machmar/pixelpine/docs/eu-compliance/declaration-of-conformity.md

# EU Declaration of Conformity — template

*Fill in the `<…>` fields, print on company letterhead, sign after the EMC report and RoHS evidence are in the
technical file. Keep the signed original with the technical file. A copy (or a web link to it) accompanies the
product when an authority asks. For RoHS/EMC it need not be in the box.*

---

**EU DECLARATION OF CONFORMITY** · No. `<PP-DoC-001>`

1. **Product:** PixelPine, decorative LED Christmas tree\
   Model / type: **PP-240-WW** · Hardware revision: **A** · Firmware: `<x.y>`\
   Batch / serial range: `<from YYWW-L>`

2. **Name and address of the manufacturer:**\
   **MachStuff s.r.o.**, Jehličková 240, 240 24 Stromečkov, Czech Republic, IČO `<company ID>`, marekmach24@gmail.com

3. This declaration of conformity is issued under the sole responsibility of the manufacturer.

4. **Object of the declaration:** a USB-C powered (5 V DC, 0.1 W max) decorative PCB luminaire in the shape of a
   Christmas tree with 240 warm-white LEDs and a capacitive touch control, as shown in the photo `<attach photo>`.

5. The object of the declaration described above is in conformity with the relevant Union harmonisation
   legislation:
   - **Directive 2014/30/EU** (electromagnetic compatibility)
   - **Directive 2011/65/EU** (RoHS) as amended by Commission Delegated Directive **(EU) 2015/863**

6. **References to the relevant harmonised standards used:**
   - EN IEC 55015:2019 + A11:2020: limits and methods of measurement of radio disturbance characteristics of
     electrical lighting and similar equipment
   - EN 61547:2009: equipment for general lighting purposes, EMC immunity requirements
   - EN IEC 63000:2018: technical documentation for the assessment of electrical and electronic products with
     respect to the restriction of hazardous substances

7. **Conformity assessment procedure:** internal production control (Module A, Annex II of Directive 2014/30/EU).
   No notified body involved.
   EMC test report: `<lab name>`, report no. `<…>`, dated `<…>`.

8. **Additional information:** the product is not a toy (Directive 2009/48/EC, Annex I). It is outside the scope of
   Regulations (EU) 2019/2020 and 2019/2015 (luminous flux ≈ 2 lm < 60 lm).

Signed for and on behalf of: **MachStuff s.r.o.**

Place and date of issue: Stromečkov, `<DD. MM. 2026>`

Name, function: `<Name Surname, jednatel / managing director>`

Signature: ______________________
