machmar/pixelpine/hardware/production/preview_stand_bottom.png

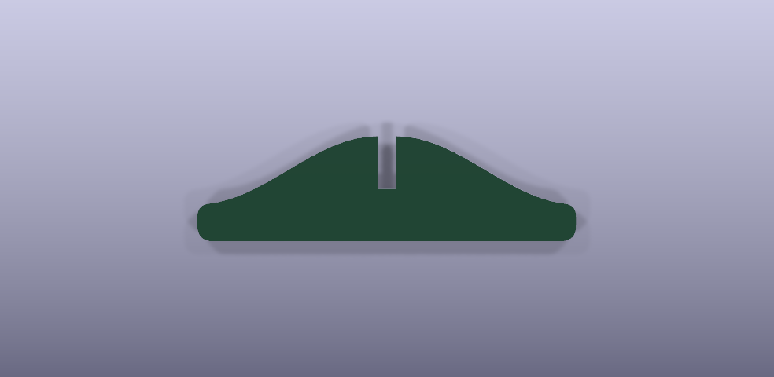
hardware/production/preview_stand_bottom.png
