machmar/pixelpine/hardware/production/preview_tree_bottom.png

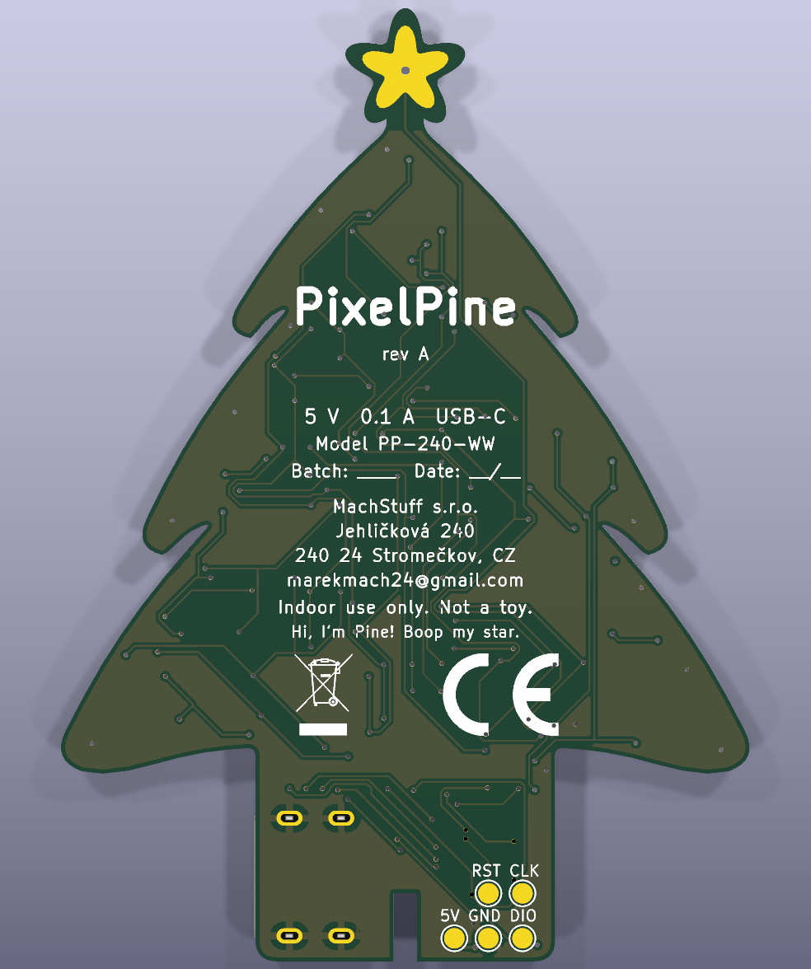
hardware/production/preview_tree_bottom.png
