machmar/pixelpine/hardware/production/preview_tree_top.png

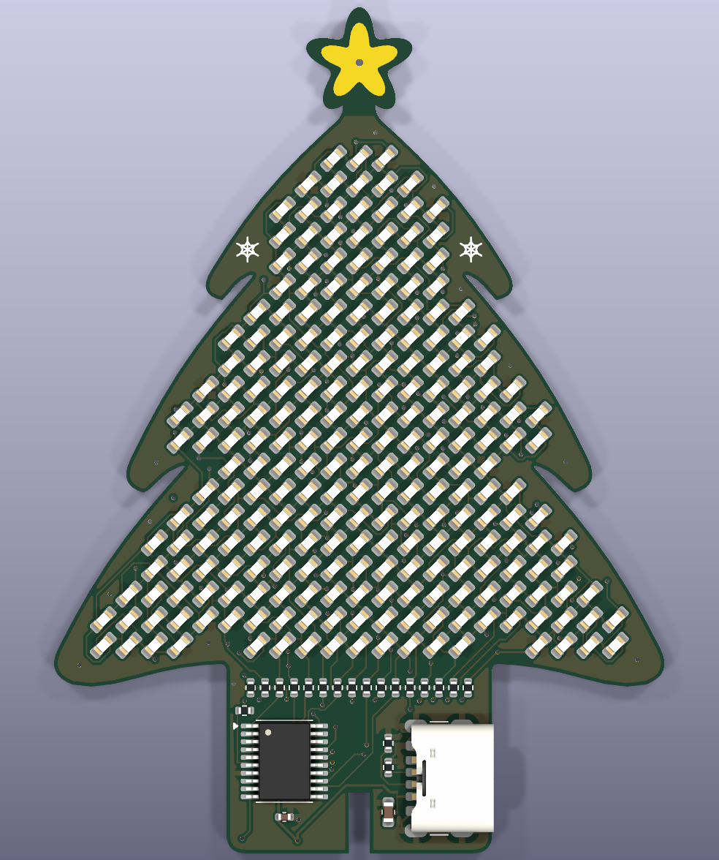
hardware/production/preview_tree_top.png
