machmar/pixelpine/hardware/renders/led_islands.png

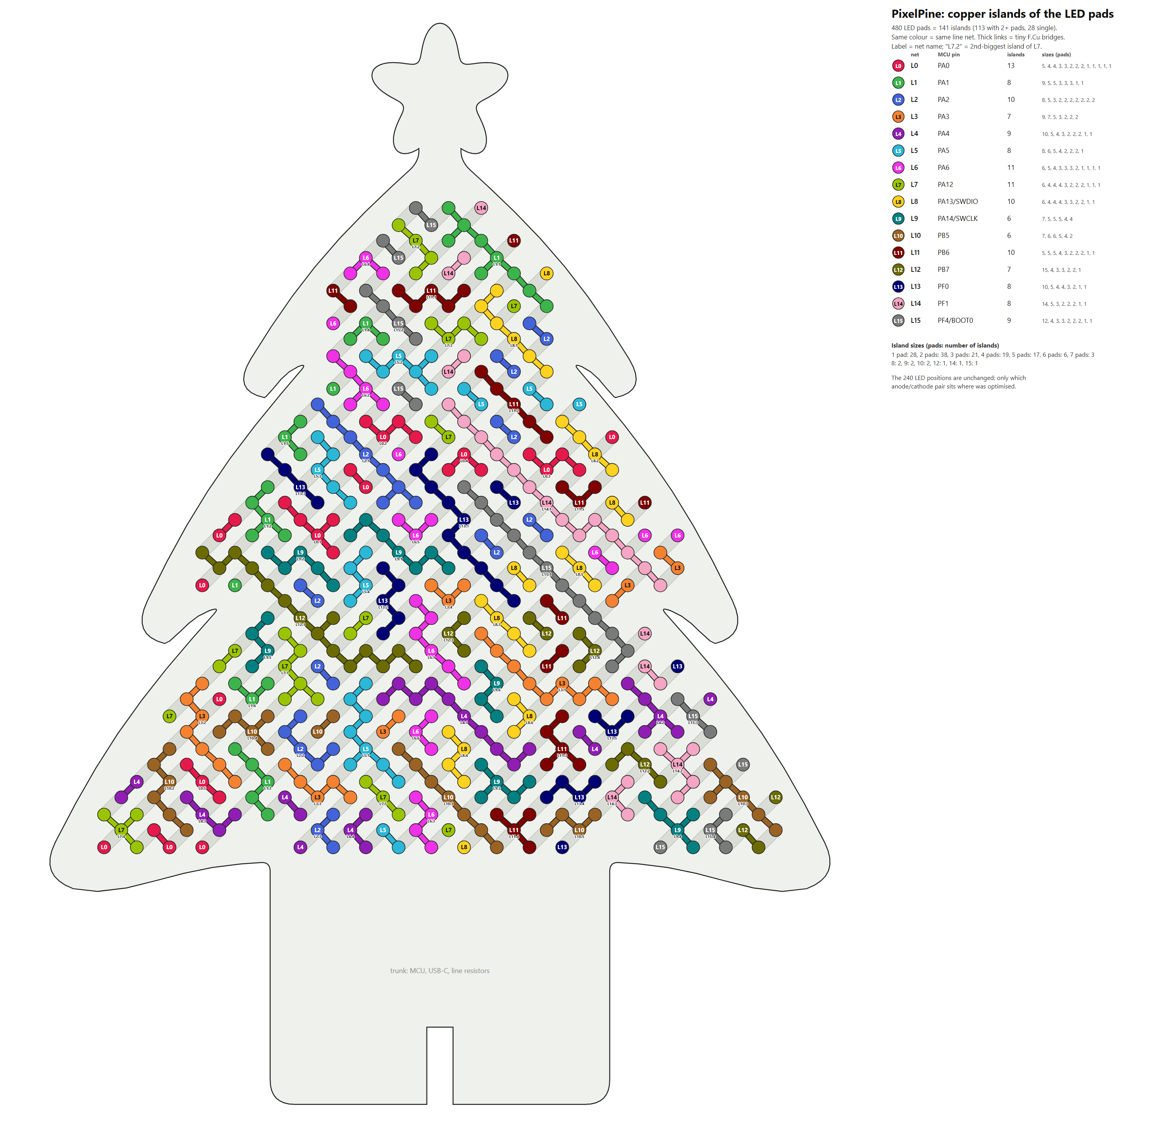
hardware/renders/led_islands.png
