machmar/pixelpine/docs/eu-compliance/labelling-and-instructions.md

# Labelling, packaging and user information — PixelPine rev A

## On the product (back silkscreen, already in the KiCad layout)

| Marking | Required by | Status |
|---|---|---|
| **CE** logo (≥ 5 mm high) | EMC / RoHS | ✅ 8.5 × 6 mm, KiCad `Symbol:CE-Logo_8.5x6mm_SilkScreen` |
| Crossed-out wheeled bin + bar | WEEE Art. 14, EN 50419 | ✅ 4.2 × 6 mm |
| Model **PP-240-WW**, rev A | EMC Art. 7(5), GPSR Art. 9(5) | ✅ |
| Batch / date field `Batch: ____ Date: __/__` | GPSR traceability | ✅ filled by paint marker or replaced by a laser mark |
| Manufacturer name, postal address, e-mail | EMC Art. 7(6), GPSR Art. 9(6) | ✅ MachStuff s.r.o., Jehličková 240, 240 24 Stromečkov, marekmach24@gmail.com (the address is made up for the school project: use the registered one for a real product) |
| Rating `5 V 0.1 A USB-C` | good practice | ✅ |
| "Indoor use only. Not a toy." | GPSR risk measures | ✅ |

## Box (70 × 100 × 25 mm kraft, one-colour print)

**Front:** PixelPine · *240 little lights. One tiny tree.* · product photo glowing

**Back (EN / CZ):**

> **PixelPine** — LED Christmas tree · Vánoční stromeček s LED\
> Model PP-240-WW · 5 V ⎓ 0.1 A · USB-C (cable and charger not included · kabel a nabíječka nejsou součástí balení)
>
> ⚠ Not a toy. Not suitable for children under 3 years – small parts. Indoor use only.\
> ⚠ Nejedná se o hračku. Nevhodné pro děti do 3 let – malé části. Pouze pro vnitřní použití.
>
> CE · crossed-out bin · packaging sorting symbols (paper) · MachStuff s.r.o., Jehličková 240, 240 24 Stromečkov, marekmach24@gmail.com ·
> Made in China · Batch `YYWW-L`

## Leaflet (A7, folded into the box)

### EN

**Hello, I'm Pine.**

My job is to show you light shows. I'm... not always very good at it.

1. Slide the stand onto my trunk: the two slots lock into each other.
2. Plug a USB-C cable into my side and into any USB charger (5 V) or computer.
3. **Tap my star** when I drift off, to remind me of my job (or to see the next show).
4. **Hold it gently** to pet me. **Pinch it front and back** for a hug. I'm ticklish.
5. If I'm asleep, maybe let me sleep. And I remember how you treat me.

**Safety**
- Use only with a CE-marked USB power supply (5 V). Use indoors only; keep dry.
- Not a toy. Contains small parts; keep away from children under 3.
- Don't bend the board or place metal objects on it while it's powered.
- Some power banks switch off at very low loads; a wall charger or computer port works best.
- The LEDs are not replaceable. When I stop working, return me to an electronics collection point, not household
  waste.

Manufacturer: MachStuff s.r.o., Jehličková 240, 240 24 Stromečkov, marekmach24@gmail.com · Declaration of conformity: `<web link>`

### CZ

**Ahoj, já jsem Pine.**

Mou prací je ukazovat vám světelné show. Moc mi to... nejde.

1. Nasuňte stojánek na můj kmen: oba zářezy do sebe zapadnou.
2. Zapojte USB-C kabel do mého boku a do libovolné USB nabíječky (5 V) nebo počítače.
3. **Klepněte na hvězdu**, když se zasním, ať si vzpomenu na svou práci (nebo pro další show).
4. **Jemně ji podržte** a pohladíte mě. **Stiskněte ji zepředu i zezadu** a obejmete mě. Mám lechtky.
5. Když spím, možná mě nechte spát. A pamatuju si, jak se ke mně chováte.

**Bezpečnost**
- Používejte pouze USB zdroj s označením CE (5 V). Pouze pro vnitřní použití, chraňte před vlhkostí.
- Nejedná se o hračku. Obsahuje malé části, uchovávejte mimo dosah dětí do 3 let.
- Desku neohýbejte a za provozu na ni nepokládejte kovové předměty.
- Některé powerbanky se při velmi malém odběru vypínají; nejlépe funguje síťová nabíječka nebo port počítače.
- LED nelze vyměnit. Po skončení životnosti odevzdejte výrobek na sběrné místo elektrozařízení, ne do komunálního odpadu.

Výrobce: MachStuff s.r.o., Jehličková 240, 240 24 Stromečkov, marekmach24@gmail.com · EU prohlášení o shodě: `<odkaz>`

## Online listing (GPSR Art. 19, marketplaces and own e-shop)

Every listing shows: manufacturer name + postal & electronic address, a product photo, the model identifier
PP-240-WW, and the warnings above in the language of the listing.
