machmar/pixelpine/hardware/pixelpine.kicad_pcb

## KiCad design hardware/pixelpine.kicad_pcb (2026-10-02)

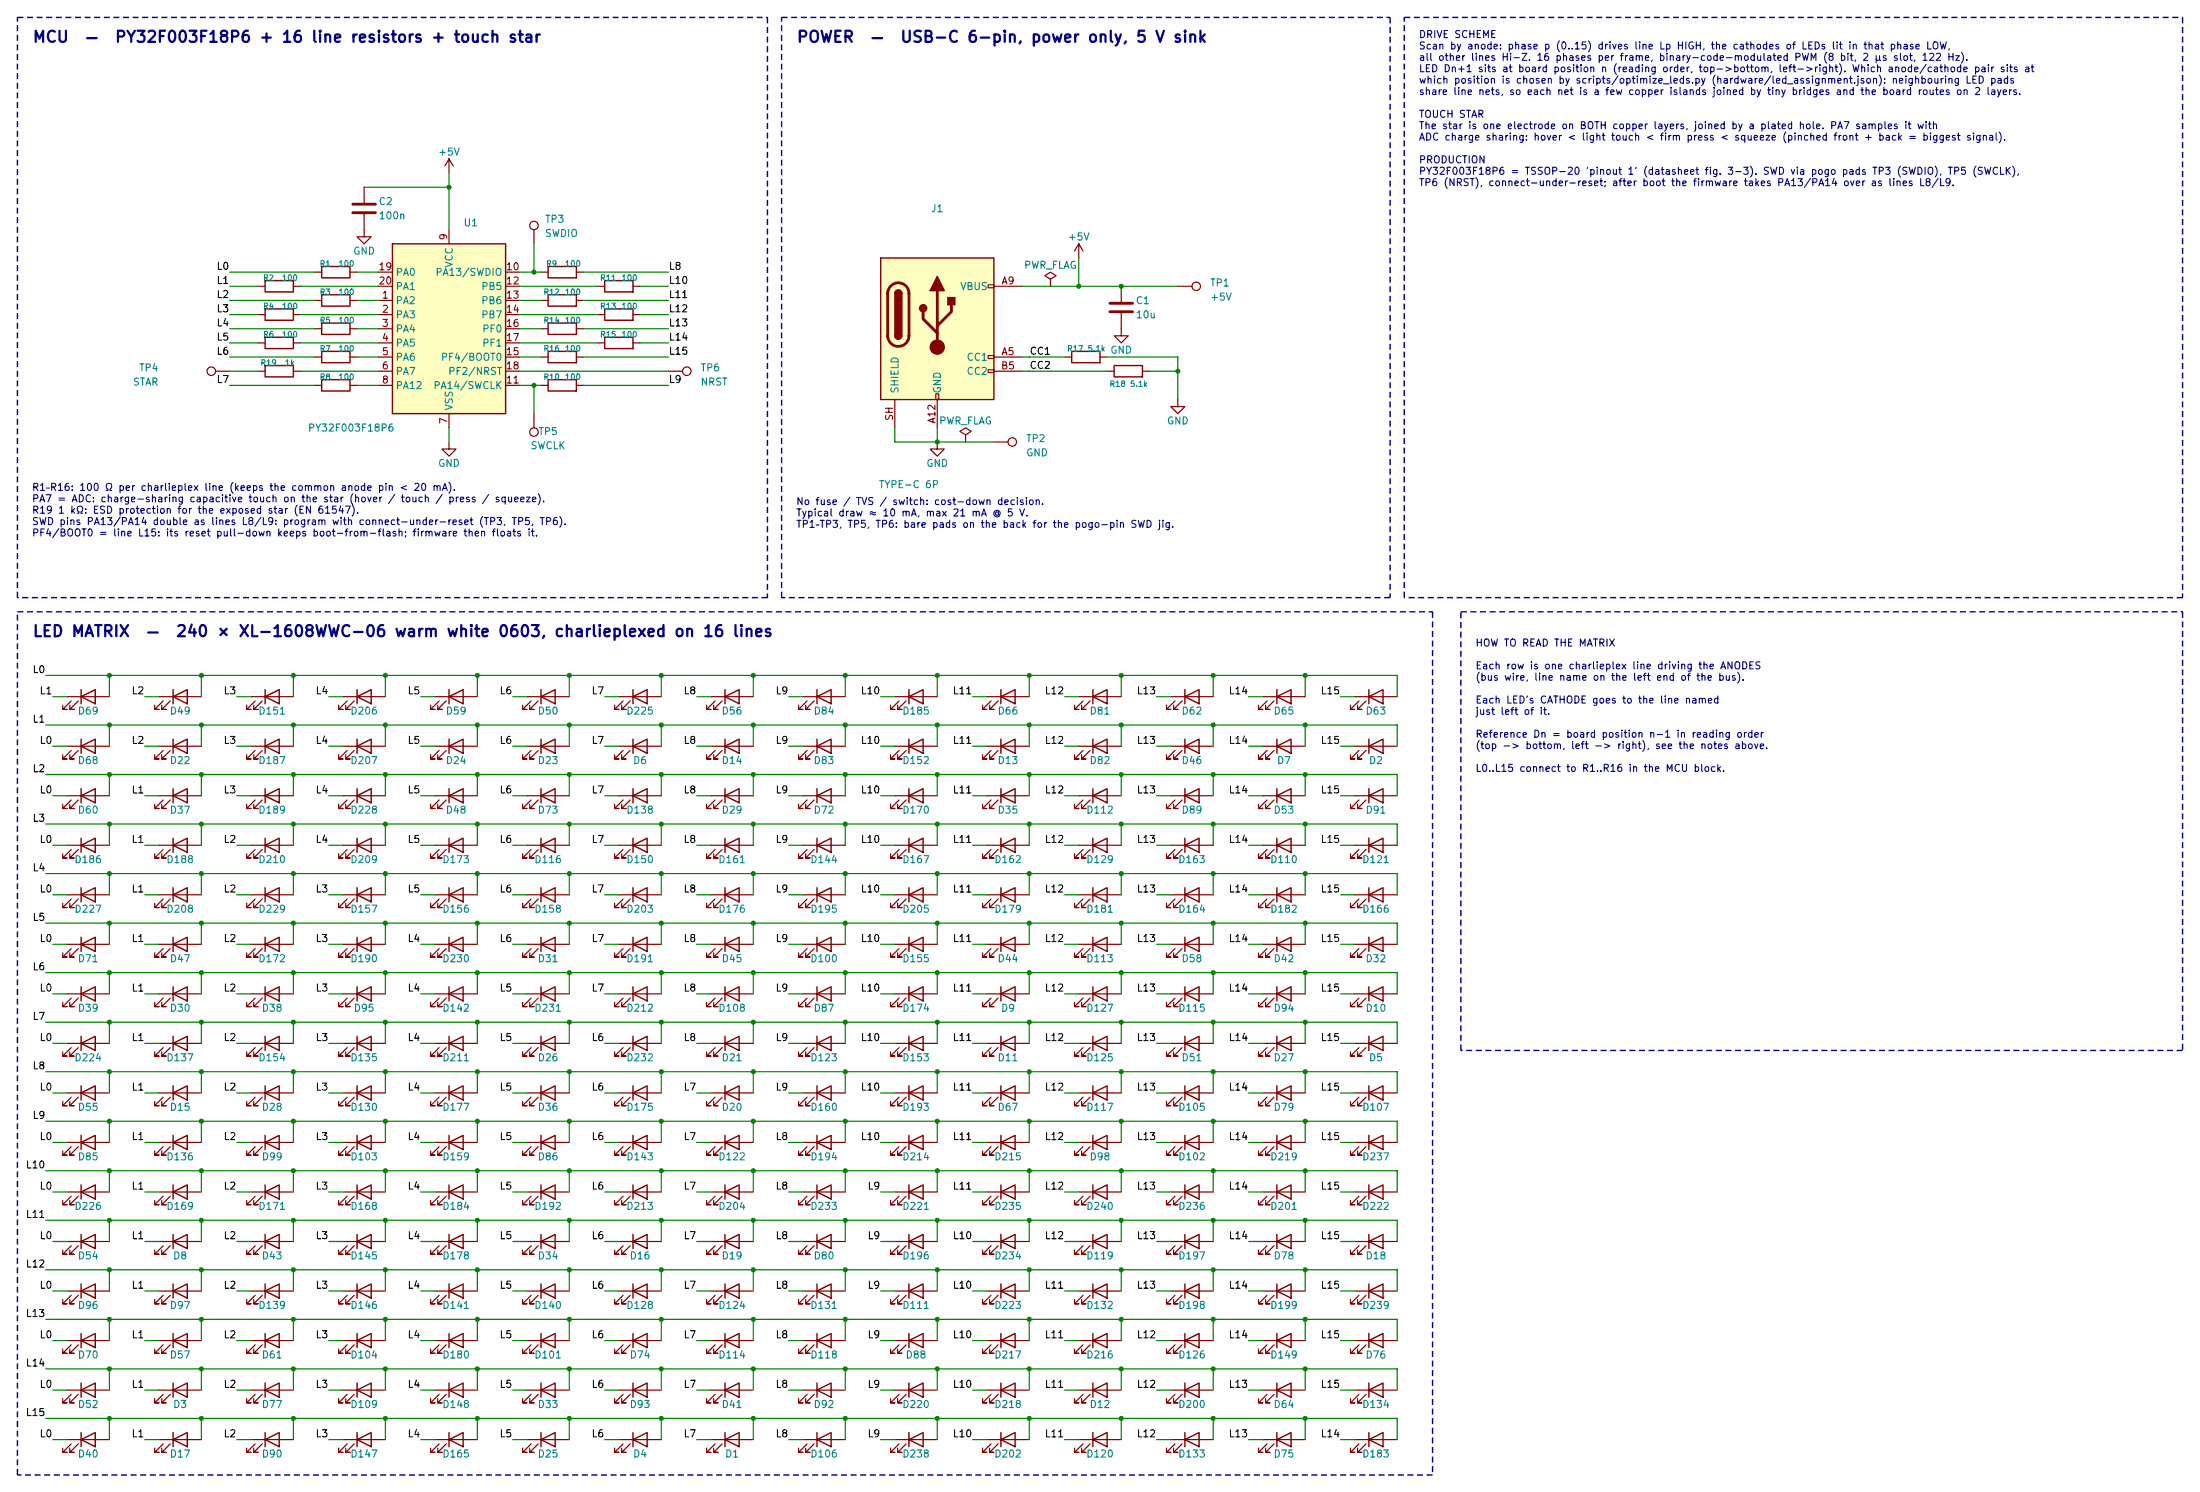
[picture p12: schematic pixelpine.kicad_sch, PixelPine - 240 LED charlieplexed PCB Christmas tree]

Parts:
C1: 10u; C_0603_1608Metric; LCSC C19702
C2: 100n; C_0402_1005Metric; LCSC C1525
D1, D2, D3, D4, D5, D6, D7, D8, D9, D10, D11, D12, D13, D14, D15, D16, D17, D18, D19, D20, D21, D22, D23, D24, D25, D26, D27, D28, D29, D30, D31, D32, D33, D34, D35, D36, D37, D38, D39, D40, D41, D42, D43, D44, D45, D46, D47, D48, D49, D50, D51, D52, D53, D54, D55, D56, D57, D58, D59, D60, D61, D62, D63, D64, D65, D66, D67, D68, D69, D70, D71, D72, D73, D74, D75, D76, D77, D78, D79, D80, D81, D82, D83, D84, D85, D86, D87, D88, D89, D90, D91, D92, D93, D94, D95, D96, D97, D98, D99, D100, D101, D102, D103, D104, D105, D106, D107, D108, D109, D110, D111, D112, D113, D114, D115, D116, D117, D118, D119, D120, D121, D122, D123, D124, D125, D126, D127, D128, D129, D130, D131, D132, D133, D134, D135, D136, D137, D138, D139, D140, D141, D142, D143, D144, D145, D146, D147, D148, D149, D150, D151, D152, D153, D154, D155, D156, D157, D158, D159, D160, D161, D162, D163, D164, D165, D166, D167, D168, D169, D170, D171, D172, D173, D174, D175, D176, D177, D178, D179, D180, D181, D182, D183, D184, D185, D186, D187, D188, D189, D190, D191, D192, D193, D194, D195, D196, D197, D198, D199, D200, D201, D202, D203, D204, D205, D206, D207, D208, D209, D210, D211, D212, D213, D214, D215, D216, D217, D218, D219, D220, D221, D222, D223, D224, D225, D226, D227, D228, D229, D230, D231, D232, D233, D234, D235, D236, D237, D238, D239, D240: XL-1608WWC-06; LED_0603_Dense; LCSC C965810
J1: TYPE-C 6P; USB_C_SHOUHAN_TYPE-C-6P; LCSC C456012
R1, R2, R3, R4, R5, R6, R7, R8, R9, R10, R11, R12, R13, R14, R15, R16: 100; R_0402_1005Metric; LCSC C25076
R17, R18: 5.1k; R_0402_1005Metric; LCSC C25905
R19: 1k; R_0402_1005Metric; LCSC C11702
TP1: +5V; TestPoint_Pad_D1.5mm
TP2: GND; TestPoint_Pad_D1.5mm
TP3: SWDIO; TestPoint_Pad_D1.5mm
TP4: STAR; TouchStar
TP5: SWCLK; TestPoint_Pad_D1.5mm
TP6: NRST; TestPoint_Pad_D1.5mm
U1: PY32F003F18P6; TSSOP-20_4.4x6.5mm_P0.65mm; LCSC C55338319

Connections:
+5V: C1.1, C2.1, J1.A9 (VBUS), J1.B9 (VBUS), TP1.1, U1.9 (VCC)
/CC1: J1.A5 (CC1), R17.1
/CC2: J1.B5 (CC2), R18.1
/L0: D39.1 (K), D40.1 (K), D49.2 (A), D50.2 (A), D52.1 (K), D54.1 (K), D55.1 (K), D56.2 (A), D59.2 (A), D60.1 (K), D62.2 (A), D63.2 (A), D65.2 (A), D66.2 (A), D68.1 (K), D69.2 (A), D70.1 (K), D71.1 (K), D81.2 (A), D84.2 (A), D85.1 (K), D96.1 (K), D151.2 (A), D185.2 (A), D186.1 (K), D206.2 (A), D224.1 (K), D225.2 (A), D226.1 (K), D227.1 (K), R1.2
/L1: D2.2 (A), D3.1 (K), D6.2 (A), D7.2 (A), D8.1 (K), D13.2 (A), D14.2 (A), D15.1 (K), D17.1 (K), D22.2 (A), D23.2 (A), D24.2 (A), D30.1 (K), D37.1 (K), D46.2 (A), D47.1 (K), D57.1 (K), D68.2 (A), D69.1 (K), D82.2 (A), D83.2 (A), D97.1 (K), D136.1 (K), D137.1 (K), D152.2 (A), D169.1 (K), D187.2 (A), D188.1 (K), D207.2 (A), D208.1 (K), R2.2
/L2: D22.1 (K), D28.1 (K), D29.2 (A), D35.2 (A), D37.2 (A), D38.1 (K), D43.1 (K), D48.2 (A), D49.1 (K), D53.2 (A), D60.2 (A), D61.1 (K), D72.2 (A), D73.2 (A), D77.1 (K), D89.2 (A), D90.1 (K), D91.2 (A), D99.1 (K), D112.2 (A), D138.2 (A), D139.1 (K), D154.1 (K), D170.2 (A), D171.1 (K), D172.1 (K), D189.2 (A), D210.1 (K), D228.2 (A), D229.1 (K), R3.2
/L3: D95.1 (K), D103.1 (K), D104.1 (K), D109.1 (K), D110.2 (A), D116.2 (A), D121.2 (A), D129.2 (A), D130.1 (K), D135.1 (K), D144.2 (A), D145.1 (K), D146.1 (K), D147.1 (K), D150.2 (A), D151.1 (K), D157.1 (K), D161.2 (A), D162.2 (A), D163.2 (A), D167.2 (A), D168.1 (K), D173.2 (A), D186.2 (A), D187.1 (K), D188.2 (A), D189.1 (K), D190.1 (K), D209.2 (A), D210.2 (A), R4.2
/L4: D141.1 (K), D142.1 (K), D148.1 (K), D156.2 (A), D157.2 (A), D158.2 (A), D159.1 (K), D164.2 (A), D165.1 (K), D166.2 (A), D176.2 (A), D177.1 (K), D178.1 (K), D179.2 (A), D180.1 (K), D181.2 (A), D182.2 (A), D184.1 (K), D195.2 (A), D203.2 (A), D205.2 (A), D206.1 (K), D207.1 (K), D208.2 (A), D209.1 (K), D211.1 (K), D227.2 (A), D228.1 (K), D229.2 (A), D230.1 (K), R5.2
/L5: D24.1 (K), D25.1 (K), D26.1 (K), D31.2 (A), D32.2 (A), D33.1 (K), D34.1 (K), D36.1 (K), D42.2 (A), D44.2 (A), D45.2 (A), D47.2 (A), D48.1 (K), D58.2 (A), D59.1 (K), D71.2 (A), D86.1 (K), D100.2 (A), D101.1 (K), D113.2 (A), D140.1 (K), D155.2 (A), D156.1 (K), D172.2 (A), D173.1 (K), D190.2 (A), D191.2 (A), D192.1 (K), D230.2 (A), D231.1 (K), R6.2
/L6: D4.1 (K), D9.2 (A), D10.2 (A), D16.1 (K), D23.1 (K), D30.2 (A), D31.1 (K), D38.2 (A), D39.2 (A), D50.1 (K), D73.1 (K), D74.1 (K), D87.2 (A), D93.1 (K), D94.2 (A), D95.2 (A), D108.2 (A), D115.2 (A), D116.1 (K), D127.2 (A), D128.1 (K), D142.2 (A), D143.1 (K), D158.1 (K), D174.2 (A), D175.1 (K), D212.2 (A), D213.1 (K), D231.2 (A), D232.1 (K), R7.2
/L7: D1.1 (K), D5.2 (A), D6.1 (K), D11.2 (A), D19.1 (K), D20.1 (K), D21.2 (A), D26.2 (A), D27.2 (A), D41.1 (K), D51.2 (A), D114.1 (K), D122.1 (K), D123.2 (A), D124.1 (K), D125.2 (A), D135.2 (A), D137.2 (A), D138.1 (K), D150.1 (K), D153.2 (A), D154.2 (A), D191.1 (K), D203.1 (K), D204.1 (K), D211.2 (A), D212.1 (K), D224.2 (A), D225.1 (K), D232.2 (A), R8.2
/L8: D14.1 (K), D15.2 (A), D20.2 (A), D21.1 (K), D28.2 (A), D29.1 (K), D36.2 (A), D45.1 (K), D55.2 (A), D56.1 (K), D67.2 (A), D79.2 (A), D80.1 (K), D92.1 (K), D105.2 (A), D106.1 (K), D107.2 (A), D108.1 (K), D117.2 (A), D118.1 (K), D130.2 (A), D131.1 (K), D160.2 (A), D161.1 (K), D175.2 (A), D176.1 (K), D177.2 (A), D193.2 (A), D194.1 (K), D233.1 (K), R9.2
/L9: D72.1 (K), D83.1 (K), D84.1 (K), D85.2 (A), D86.2 (A), D87.1 (K), D88.1 (K), D98.2 (A), D99.2 (A), D100.1 (K), D102.2 (A), D103.2 (A), D111.1 (K), D122.2 (A), D123.1 (K), D136.2 (A), D143.2 (A), D144.1 (K), D159.2 (A), D160.1 (K), D194.2 (A), D195.1 (K), D196.1 (K), D214.2 (A), D215.2 (A), D219.2 (A), D220.1 (K), D221.1 (K), D237.2 (A), D238.1 (K), R10.2
/L10: D152.1 (K), D153.1 (K), D155.1 (K), D167.1 (K), D168.2 (A), D169.2 (A), D170.1 (K), D171.2 (A), D174.1 (K), D184.2 (A), D185.1 (K), D192.2 (A), D193.1 (K), D201.2 (A), D202.1 (K), D204.2 (A), D205.1 (K), D213.2 (A), D214.1 (K), D217.1 (K), D218.1 (K), D221.2 (A), D222.2 (A), D223.1 (K), D226.2 (A), D233.2 (A), D234.1 (K), D235.2 (A), D236.2 (A), D240.2 (A), R11.2
/L11: D8.2 (A), D9.1 (K), D11.1 (K), D12.1 (K), D13.1 (K), D16.2 (A), D18.2 (A), D19.2 (A), D34.2 (A), D35.1 (K), D43.2 (A), D44.1 (K), D54.2 (A), D66.1 (K), D67.1 (K), D78.2 (A), D80.2 (A), D119.2 (A), D120.1 (K), D132.1 (K), D145.2 (A), D162.1 (K), D178.2 (A), D179.1 (K), D196.2 (A), D197.2 (A), D215.1 (K), D216.1 (K), D234.2 (A), D235.1 (K), R12.2
/L12: D81.1 (K), D82.1 (K), D96.2 (A), D97.2 (A), D98.1 (K), D111.2 (A), D112.1 (K), D113.1 (K), D117.1 (K), D119.1 (K), D124.2 (A), D125.1 (K), D126.1 (K), D127.1 (K), D128.2 (A), D129.1 (K), D131.2 (A), D132.2 (A), D133.1 (K), D139.2 (A), D140.2 (A), D141.2 (A), D146.2 (A), D181.1 (K), D198.2 (A), D199.2 (A), D200.1 (K), D223.2 (A), D239.2 (A), D240.1 (K), R13.2
/L13: D46.1 (K), D51.1 (K), D57.2 (A), D58.1 (K), D61.2 (A), D62.1 (K), D64.1 (K), D70.2 (A), D74.2 (A), D75.1 (K), D76.2 (A), D88.2 (A), D89.1 (K), D101.2 (A), D102.1 (K), D104.2 (A), D105.1 (K), D114.2 (A), D115.1 (K), D118.2 (A), D126.2 (A), D149.2 (A), D163.1 (K), D164.1 (K), D180.2 (A), D197.1 (K), D198.1 (K), D216.2 (A), D217.2 (A), D236.1 (K), R14.2
/L14: D3.2 (A), D7.1 (K), D12.2 (A), D27.1 (K), D33.2 (A), D41.2 (A), D42.1 (K), D52.2 (A), D53.1 (K), D64.2 (A), D65.1 (K), D77.2 (A), D78.1 (K), D79.1 (K), D92.2 (A), D93.2 (A), D94.1 (K), D109.2 (A), D110.1 (K), D134.2 (A), D148.2 (A), D149.1 (K), D182.1 (K), D183.1 (K), D199.1 (K), D200.2 (A), D201.1 (K), D218.2 (A), D219.1 (K), D220.2 (A), R15.2
/L15: D1.2 (A), D2.1 (K), D4.2 (A), D5.1 (K), D10.1 (K), D17.2 (A), D18.1 (K), D25.2 (A), D32.1 (K), D40.2 (A), D63.1 (K), D75.2 (A), D76.1 (K), D90.2 (A), D91.1 (K), D106.2 (A), D107.1 (K), D120.2 (A), D121.1 (K), D133.2 (A), D134.1 (K), D147.2 (A), D165.2 (A), D166.1 (K), D183.2 (A), D202.2 (A), D222.1 (K), D237.1 (K), D238.2 (A), D239.1 (K), R16.2
GND: C1.2, C2.2, J1.A12 (GND), J1.B12 (GND), J1.SH (SHIELD), R17.2, R18.2, TP2.1, U1.7 (VSS)
unnamed: R19.2, TP4.1
unnamed: R1.1, U1.19 (PA0)
unnamed: R2.1, U1.20 (PA1)
unnamed: R3.1, U1.1 (PA2)
unnamed: R4.1, U1.2 (PA3)
unnamed: R5.1, U1.3 (PA4)
unnamed: R6.1, U1.4 (PA5)
unnamed: R7.1, U1.5 (PA6)
unnamed: R19.1, U1.6 (PA7)
unnamed: R8.1, U1.8 (PA12)
unnamed: R9.1, TP3.1, U1.10 (PA13/SWDIO)
unnamed: R10.1, TP5.1, U1.11 (PA14/SWCLK)
unnamed: R11.1, U1.12 (PB5)
unnamed: R12.1, U1.13 (PB6)
unnamed: R13.1, U1.14 (PB7)
unnamed: R14.1, U1.16 (PF0)
unnamed: R15.1, U1.17 (PF1)
unnamed: TP6.1, U1.18 (PF2/NRST)
unnamed: R16.1, U1.15 (PF4/BOOT0)

Notes on the sheet:
MCU — PY32F003F18P6 + 16 line resistors + touch star
R1–R16: 100 Ω per charlieplex line (keeps the common anode pin < 20 mA). PA7 = ADC: charge-sharing capacitive touch on the star (hover / touch / press / squeeze). R19 1 kΩ: ESD protection for the exposed star (EN 61547). SWD pins PA13/PA14 double as lines L8/L9: program with connect-under-reset (TP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
POWER — USB-C 6-pin, power only, 5 V sink
No fuse / TVS / switch: cost-down decision. Typical draw ≈ 10 mA, max 21 mA @ 5 V. TP1–TP3, TP5, TP6: bare pads on the back for the pogo-pin SWD jig.
DRIVE SCHEME Scan by anode: phase p (0..15) drives line Lp HIGH, the cathodes of LEDs lit in that phase LOW, all other lines Hi-Z. 16 phases per frame, binary-code-modulated PWM (8 bit, 2 µs slot, 122 Hz). LED Dn+1 sits at board position n (reading order, top->bottom, left->right). Which anode/cath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
LED MATRIX — 240 × XL-1608WWC-06 warm white 0603, charlieplexed on 16 lines
HOW TO READ THE MATRIX Each row is one charlieplex line driving the ANODES (bus wire, line name on the left end of the bus). Each LED's CATHODE goes to the line named just left of it. Reference Dn = board position n-1 in reading order (top -> bottom, left -> right), see the notes above. L0..L15 con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

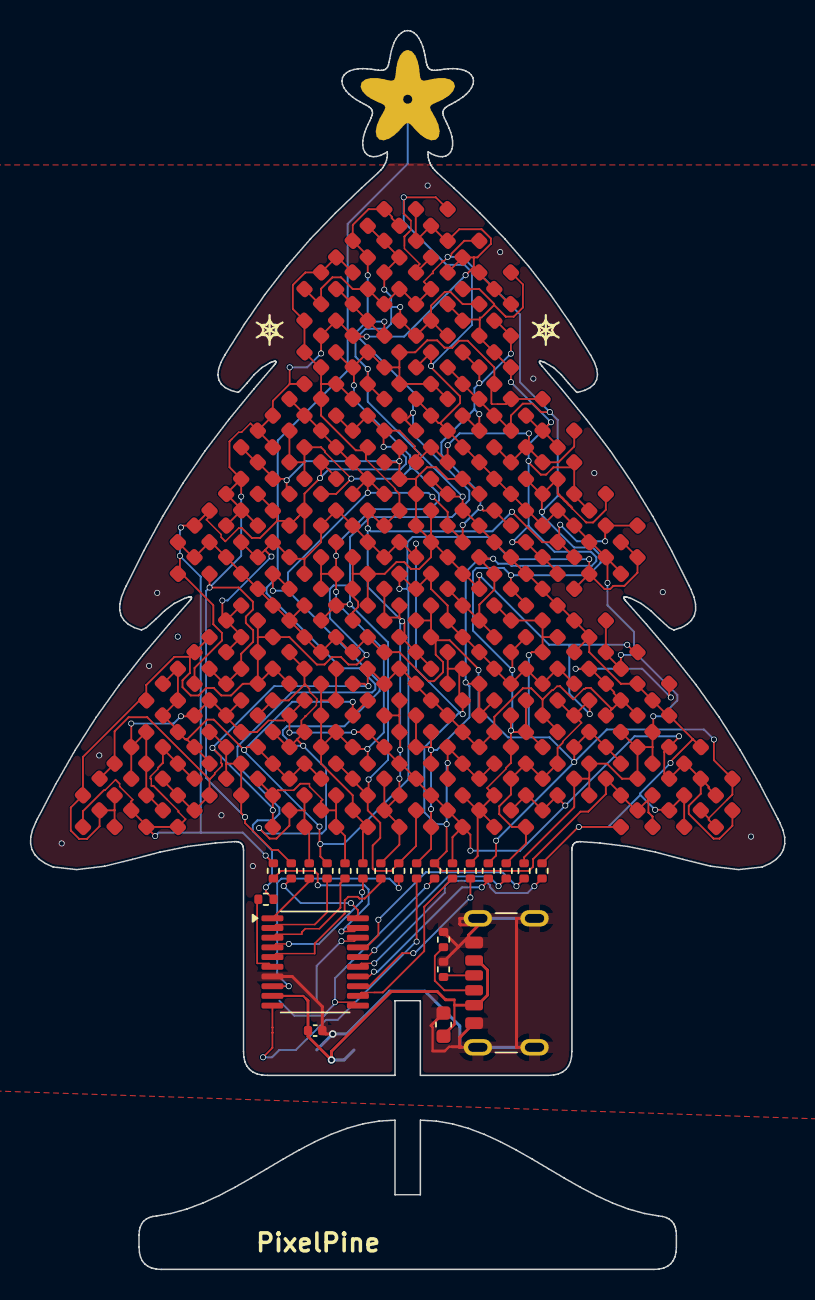
[picture p13: board pixelpine.kicad_pcb from above]

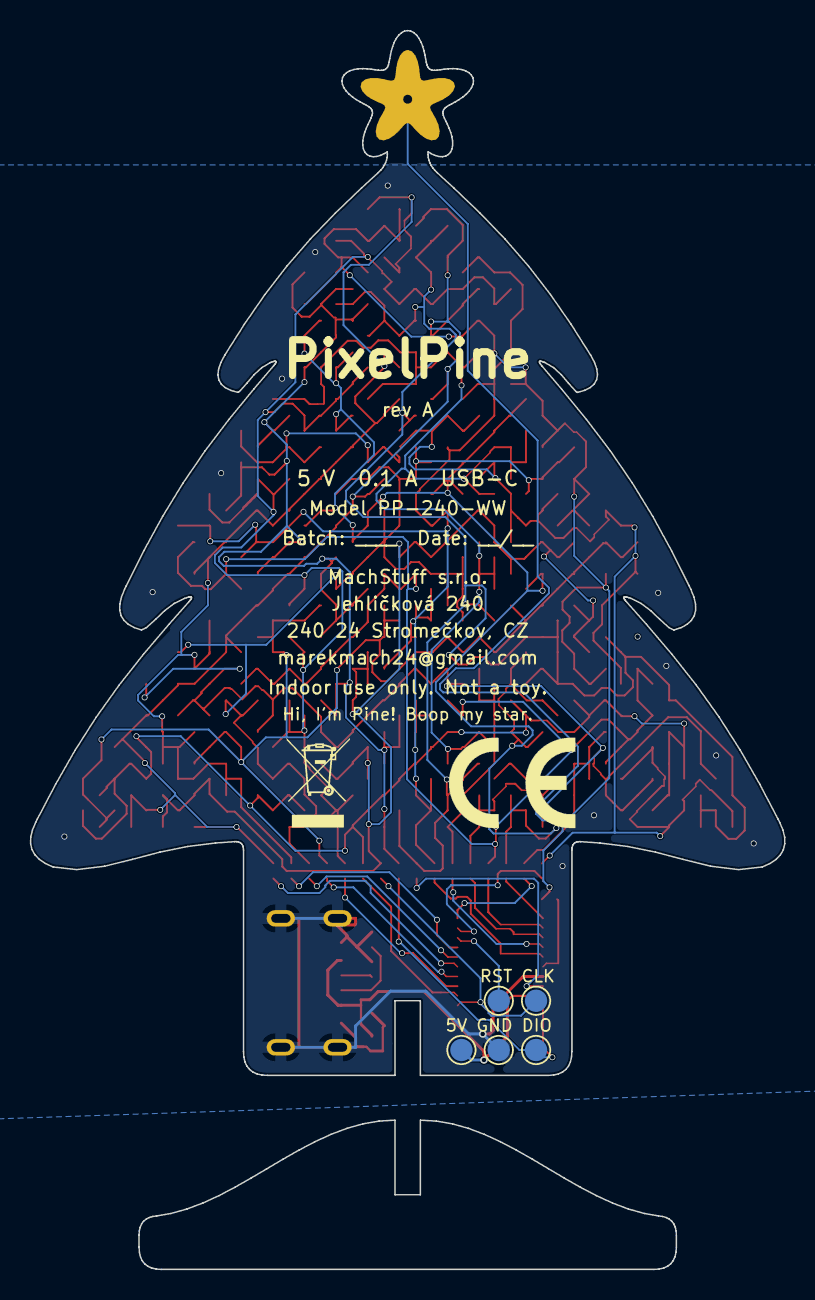
[picture p14: board pixelpine.kicad_pcb from below]

Board: 2 copper layers, 50.5 x 83.0 mm, 271 parts (7 on the bottom side), 39 nets.

Other parts of the board:
LOGO1: CE-Logo_8.5x6mm_SilkScreen
LOGO2: WEEE-Logo_4.2x6mm_SilkScreen
