machmar/pixelpine/(commit log)

2026-10-02 PixelPine rev A: PCB Christmas tree with 240 charlieplexed LEDs
    KiCad 10 project (schematic, hand-finished 2-layer board, JLC order files),
    the generator scripts, the animation simulator (published to GitHub Pages
    from simulator/), the firmware sizing prototype, and the docs (market
    analysis, cost, power, EU compliance) with PDF exports.
    [jlc_bom.csv, pixelpine.kicad_pcb, pixelpine.kicad_sch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]
2026-10-07 Add LED copper-island drawings, ignore presentation folder
    hardware/renders/led_islands.svg/.png show how the optimised LED pair
    arrangement joins the 480 LED pads into 141 copper islands (one colour
    per charlieplex line). The presentation folder (talk source, videos and
    exports, ~250 MB) stays local.
2026-11-03 Add J-Link flashing setup, first board bring-up results
    pyOCD + Puya PY32F0xx pack drives the J-Link; flash.py checks VTref,
    connects under reset, programs, verifies and ends with an NRST reset.
    First rev A board: 4.97 V rail, SWD and power-on boot from flash OK.
    [flash.py]
2026-11-03 Start product firmware: simulator port, scan driver, first flash
    firmware/pixelpine/ ports the simulator's shows, faces, scene engine,
    touch classifier and brain to C (fixed-point per-LED maths, double for
    the per-frame logic), plus the PY32F003 BCM charlieplex scan driver and
    a PC test build. flash.py now resets via NRST after closing the session.
    [brain.c, build.py, face.c, flash.py, fx.c, fx.h, gen_tables.py]
2026-11-03 Firmware matches the simulator: harness, precision fixes
    test/simref.js runs simulator/index.html headless as the reference;
    test/compare.py compares it with the PC build frame by frame. The brain
    and state machine now match exactly, LED levels within 1 step.
    [compare.py, fx.c, fx.h, gen_tables.py, pine.h, shows.c]
2026-11-03 Firmware speed: fits 50 fps on the 24 MHz PY32
    On-target CPU bench (KEEP_SWD build), fast splat, hash rows, fixed-point
    particles, fdlibm-free fast sine for faces, MULS-forced hashes, catch-up
    main loop that skips the output stage after a late frame.
    [build.py, face.c, fx.c, fx.h, gen_tables.py, main.c, pine.h]
2026-11-03 Touch star, bond storage on the board; light sensing ruled out
    Touch: charge-sharing samples spread over the frame inside the scan ISR
    (averages out mains hum), ratio-to-baseline mapping onto the simulator's
    scale, calibrated on the first board. ADC re-enabled per conversion
    (this PY32 clears ADEN after each one). Bond saved to an 8-page flash
    ring, verified on hardware. LED-as-photodiode can't work in a full
    charlieplex (anti-parallel pairs), so ambient stays "lights on".
    Calibration, gesture and stack tools in test/.
2026-11-03 Product firmware done: watchdog, version, docs
    Independent watchdog (LSI enabled first, verified with a deliberate
    hang), version string at 0x080000C0, firmware README with the harness
    results, CPU budget, touch calibration and the rev A light-sensing
    finding. Project README, animations and power docs updated, PDFs
    re-exported.
2026-11-03 Scan: latch each phase's masks, drain lines between phases
    Masks rewritten mid-phase let an LED crossing a bit boundary (127->128)
    show 255 for one refresh: bright flashes, worst in the radar. Each phase
    now latches its 8 masks at its start. All lines are also pulled low
    between phases so charge left on floating lines doesn't leak through
    other LEDs (ghosting).
    [scan.c]
2026-11-03 Scan: no pulls on the lines, no anode in empty slots, sharing compensation
    The reset pulls on PA13/PA14 (now lines L8/L9) kept ~30 LEDs glowing
    with every LED off. Slots with no LED lit no longer drive the anode
    (it charged the floating lines through its LEDs), the drain step is
    gone, and each phase's duties are pre-scaled to cancel anode current
    sharing (the simulator's "Compensated" model) so LEDs alone in a slot
    don't flare. Timer guard against a wrapped slot. diag build added.
    [build.py, main.c, scan.c]
2026-11-03 Firmware README: scan pitfalls found on the board
2026-11-03 Embers bed only in the bottom 3 rows and alive; no glow in ripple or faces
    Rising sparks: the fixed floor glow becomes slowly drifting ember
    patches, bottom 3 rows only. Star ripple: no halo around the star.
    Faces: no constant body glow (only the sneeze flash keeps it). Same
    change in the simulator and the firmware; harness still matches.
    [build.py, face.c, shows.c]
2026-11-03 flash.py: --no-nrst for blank boards wired with SWDIO/SWCLK/GND only
2026-11-03 flash.py: --cmsis for CMSIS-DAP probes (Flipper Zero DAP Link)
    [flash.py]
2026-11-03 Flashing README: Flipper Zero DAP Link recipe (3.3 V from the Flipper)
2026-11-04 Touch-field experiment: LED lines as electrodes don't work
    touchfield build + test/touchfield.py: fingertip changes the L0-L6
    readings by <= 0.4 % against 4-13 % noise (lines are ~100-200 pF of
    LEDs and copper), palm ~1.5 %. The star works (0.22 % noise).
    [build.py, hw.h, main.c, sense.c]
2026-11-04 Touch-field round 2: mains-hum pickup on the LED lines finds the finger
    Board records on its own (no SWD traffic), all idle lines held at 0 V,
    three methods per line. Charge sharing and RC timing barely see a
    fingertip; the hum spread on a floating line does: up to 88x its noise,
    different lines for different spots (bottom: L4-L6, middle: L2/L3,
    right: L3/L6). Top and left are covered by non-ADC lines.
    [main.c]
2026-11-04 Touch-field experiment 3: 9 spots, digital vs ADC hum listening
    Digital listening never sees the hum (a floating line stays below the
    logic threshold). ADC hum spread over 20 ms separates 7 of 9 spots by
    which lines react; lower right (no ADC line copper) and top vs
    middle-left can't be told apart. Readings saturated at 255.
2026-11-04 Safety: debug builds never light LEDs, watchdog everywhere, crash blanks lines
    Keep-SWD builds left L8 (SWDIO) high on the probe while the scan pulled
    other lines low: LEDs stuck at full current, twice. Those builds now
    keep every mask empty. The watchdog runs in every build and the fault
    handler floats every line before it stops. Listening experiment build
    (touch field with LED gaps) added; its LED part needs a redesign.
    [build.py, main.c, scan.c]
2026-11-04 Touch-field experiment 4: listening in short gaps while Pine runs
    Self-paced by the tree (digit, then blinking spots), crash record kept
    across resets, results read without halting. With LEDs running the gap
    readings are dominated by the lines settling after the scan (rest level
    ~2.5x the LEDs-off one, all lines moving together), so the spots don't
    separate.
    [build.py, main.c]
2026-11-04 Touch-field experiment 5: drain to 0 V, then listen - it works
    Standalone build (python build.py drain, test/drain.py): a moving wave keeps every
    line scanning; once per frame, at a random phase, the scan pauses for one gap.
    Settings: A = no drain, float 0.7 ms (experiment 4); B-E = all 16 lines driven to
    0 V for 5 us, then L0-L6 (analog mode) and L11 float 20 us / 0.2 / 0.7 / 2 ms, one
    ADC read per line; COMP1 (PA1 = L1) and COMP2 (PB6 = L11) against 1/4 Vrefint.
    Result: without the drain nothing is seen (rest sd 270-560 counts). With it the
    rest reading is flat (~30-50 counts, sd < 8) and all 9 spots stand out, each with
    its own line pattern; even 20 us of float gives z 3-13, 0.2-0.7 ms g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
2026-11-04 Drop the whole-tree touch field; document why
    The LED lines pick up the mains hum a fingertip carries (experiments 2-5; the
    drain-then-listen method separates all 9 test spots on a laptop's USB port).
    A full driver tested on the board showed the signal depends on the supply: no
    signal on a powerbank, 7-60 counts on a wall charger against ~1 at rest, with
    3-4 of 9 spots placed right. Too weak and too variable for a product feature.
    Removed: the experiment builds (touchfield, listen, drain) and their scripts.
    Kept: the safety changes made along the way (debug builds never light LEDs,
    watchdog in every build, crash record). Fixed the showcycle build (it needs the
    star sensor since scan.c calls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
    [build.py, hw.h, main.c, sense.c]
2026-11-04 Smoother faces, squeeze that works: 10-bit scan, touch recalibrated
    - Scan: 10-bit BCM at the same 122 Hz (1 us base slot, bit 0 shown on every
    other refresh). Pixels fade in from 3 % brightness instead of popping on at
    6 %; steps 4x finer. Board: GPIO stores 1 cycle, no late frames.
    - Touch classifier (firmware + simulator): a press is decided on release or
    after 1.5 s in the press band, and a touch that went that deep is never a
    pet. Real squeezes climb through the press band for up to 1.3 s, so every
    one fired "press" (answered like a tap) first.
    - Touch levels recalibrated for a free-standing board: the bring-up
    calibration had the J-Link's ground attached, which deepens the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
